NormSohl/daisy-freeze-pedal/pcb/carrier/drc-report.txt

** Drc report for /home/claude/daisy-freeze-pedal/pcb/carrier/carrier.kicad_pcb **
** Created on 2026-10-27 16:27:48 **

** Found 0 DRC violations **

** Found 0 unconnected pads **

** Found 0 Footprint errors **

** End of Report **
