NormSohl/daisy-freeze-pedal/enclosure/renders/back.png

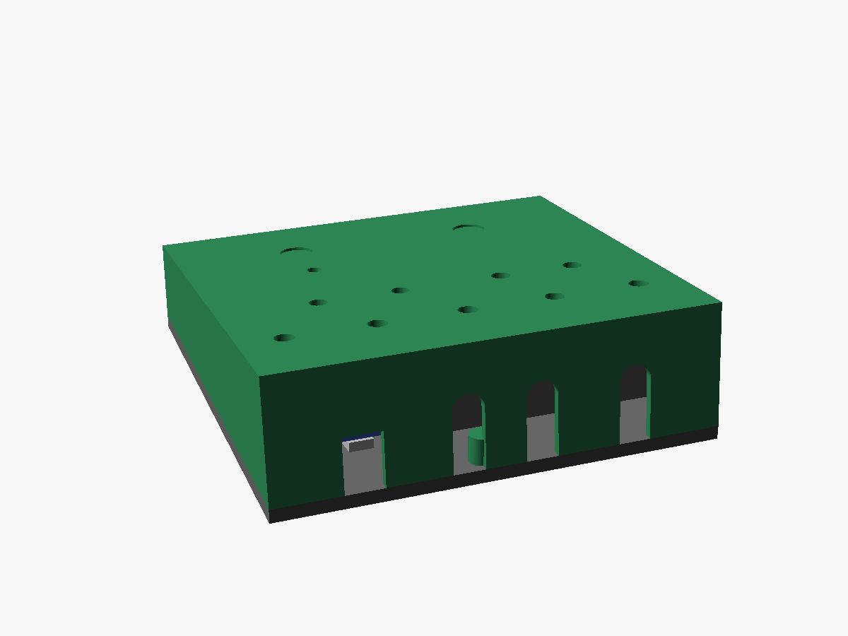
enclosure/renders/back.png
