NormSohl/daisy-freeze-pedal/enclosure/renders/shell-top.png

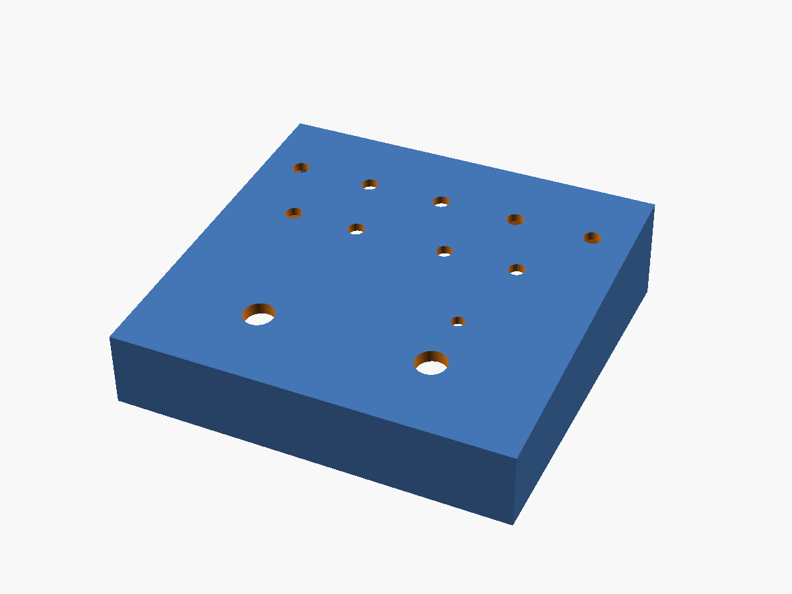
enclosure/renders/shell-top.png
