NormSohl/daisy-freeze-pedal/enclosure/renders/underside.png

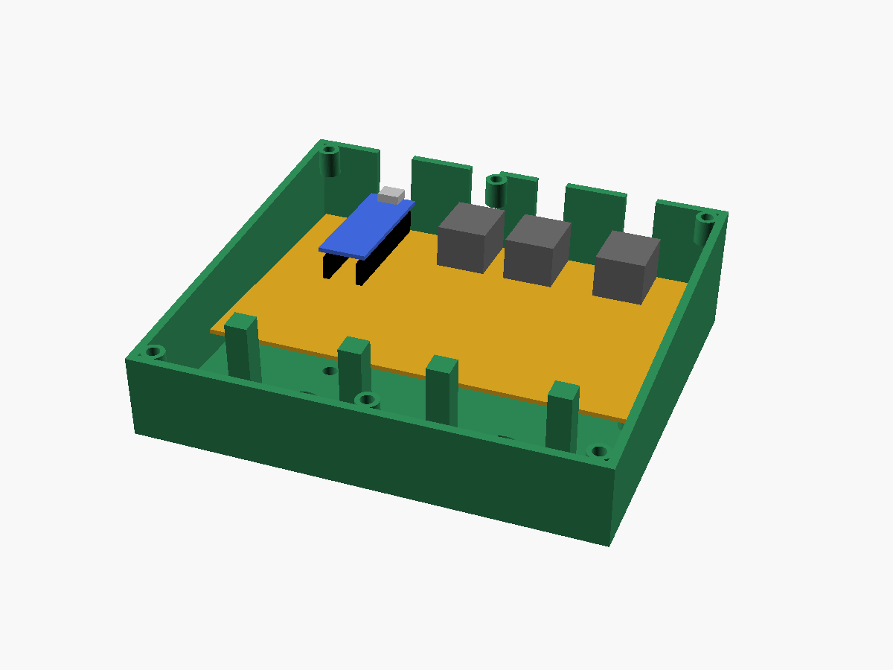
enclosure/renders/underside.png
