NormSohl/daisy-freeze-pedal/pcb/carrier/fab/bom.csv

Qty | References | Value | Part
2 | C1 C2 | 10u | 10 uF ≥25 V X7R radial MLCC, 5.08 mm leads (e.g. TDK FG20X7R1H106KRT06, 50 V, on Digi-Key)
1 | D1 | Red/Green | 5 mm bi-colour LED, common cathode (red/green), on a 4 mm spacer
1 | J1 | Freeze footswitch | No connector: solder 24-26 AWG leads into the J pads (either way round). Footswitch: soft-touch momentary SPST, panel mounted (Tayda)
1 | J2 | Clear footswitch | No connector: solder 24-26 AWG leads into the J pads (either way round). Footswitch: soft-touch momentary SPST, panel mounted (Tayda)
1 | J3 | In (mono; grounded when empty) | Neutrik NMJ6HCD2
1 | J4 | Out L / Mono | Neutrik NMJ6HCD2
1 | J5 | Out R (ring switch = plug detect) | Neutrik NMJ6HCD2
2 | R1 R2 | 470 | 470R 1/4 W (choose per LED)
2 | R3 R4 | 100k | 100k 1/4 W metal film
1 | RV1 | B10K Dry | Alpha RV09AF-40-20K-B10K (20 mm knurled shaft)
1 | RV2 | B10K Loop | Alpha RV09AF-40-20K-B10K (20 mm knurled shaft)
1 | RV3 | B10K −8 | Alpha RV09AF-40-20K-B10K (20 mm knurled shaft)
1 | RV4 | B10K +5 | Alpha RV09AF-40-20K-B10K (20 mm knurled shaft)
1 | RV5 | B10K +8 | Alpha RV09AF-40-20K-B10K (20 mm knurled shaft)
1 | RV6 | B10K Fade | Alpha RV09AF-40-20K-B10K (20 mm knurled shaft)
1 | RV7 | B10K Texture | Alpha RV09AF-40-20K-B10K (20 mm knurled shaft)
1 | SW1 | Single / Multi | E-Switch 100SP1T1B1M2RE (gold contacts; any 100SP1…M2 fits)
1 | SW2 | +5 up / down | E-Switch 100SP1T1B1M2RE (gold contacts; any 100SP1…M2 fits)
1 | U1 | Daisy Seed3 | Electrosmith Daisy Seed3 (on 2x 1x20 female headers)
