NormSohl/daisy-freeze-pedal/pcb/carrier/fab/mouser-bom.csv

Mfr Part Number | Manufacturer | Quantity | Customer Part Number | Description
RV09AF-40-20K-B10K | Alpha (Taiwan) | 8 | RV1-RV7 + spare | Pot 10K lin, 9 mm vertical, 20 mm knurled plastic shaft
100SP1T1B1M2RE | E-Switch | 2 | SW1 SW2 | Toggle SPDT on-on, PCB mount, 1/4-40 bushing, gold contacts
NMJ6HCD2 | Neutrik | 3 | J3 J4 J5 | 1/4 in TRS jack, horizontal PCB, switched
FG20X7R1H106KRT06 | TDK | 2 | C1 C2 | 10 uF 50 V X7R radial MLCC, 5 mm leads
PPTC201LFBN-RC | Sullins | 2 | U1 socket | 1x20 female header 2.54 mm, 8.5 mm tall, for Daisy Seed3
MFR-25FBF52-470R | Yageo | 5 | R1 R2 | 470 ohm 1/4 W metal film
MFR-25FBF52-100K | Yageo | 5 | R3 R4 | 100k 1/4 W metal film
WP59EGW | Kingbright | 2 | D1 | 5 mm red/green bi-colour LED, 3-lead common cathode
