NormSohl/daisy-freeze-pedal/enclosure/stl/plate.stl

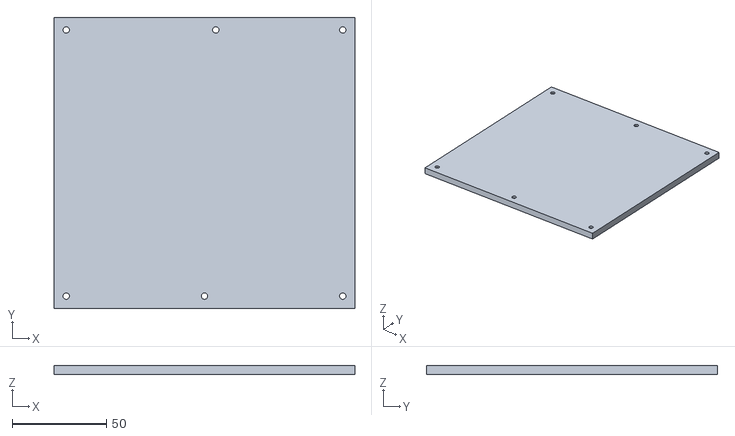
[picture p10: CAD file, 2026-10-28]
enclosure/stl/plate.stl
160.0 x 154.5 x 5.00
