NormSohl/daisy-freeze-pedal/enclosure/stl/shell.stl

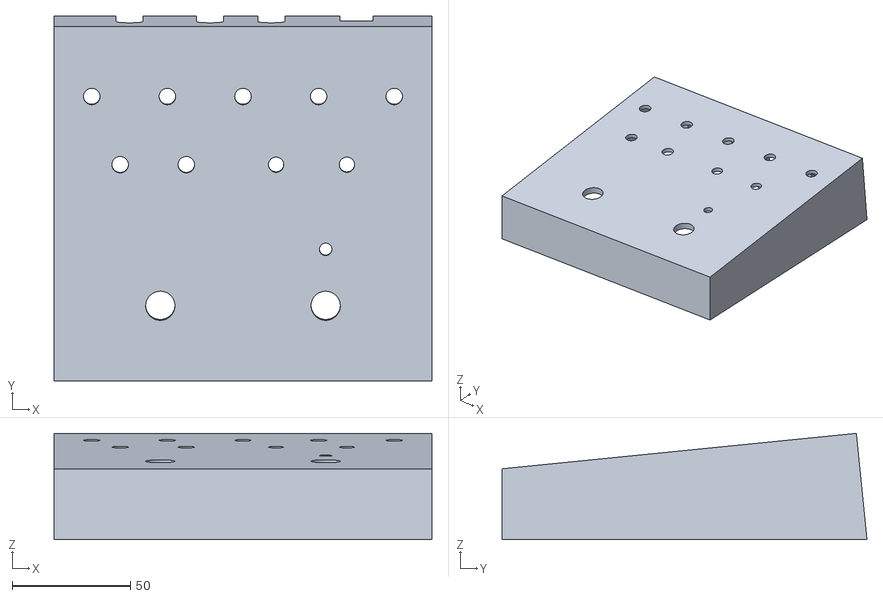
[picture p11: CAD file, 2026-10-28]
enclosure/stl/shell.stl
160.0 x 154.5 x 45.0
