NormSohl/daisy-freeze-pedal/pcb/carrier/carrier-schematic.pdf

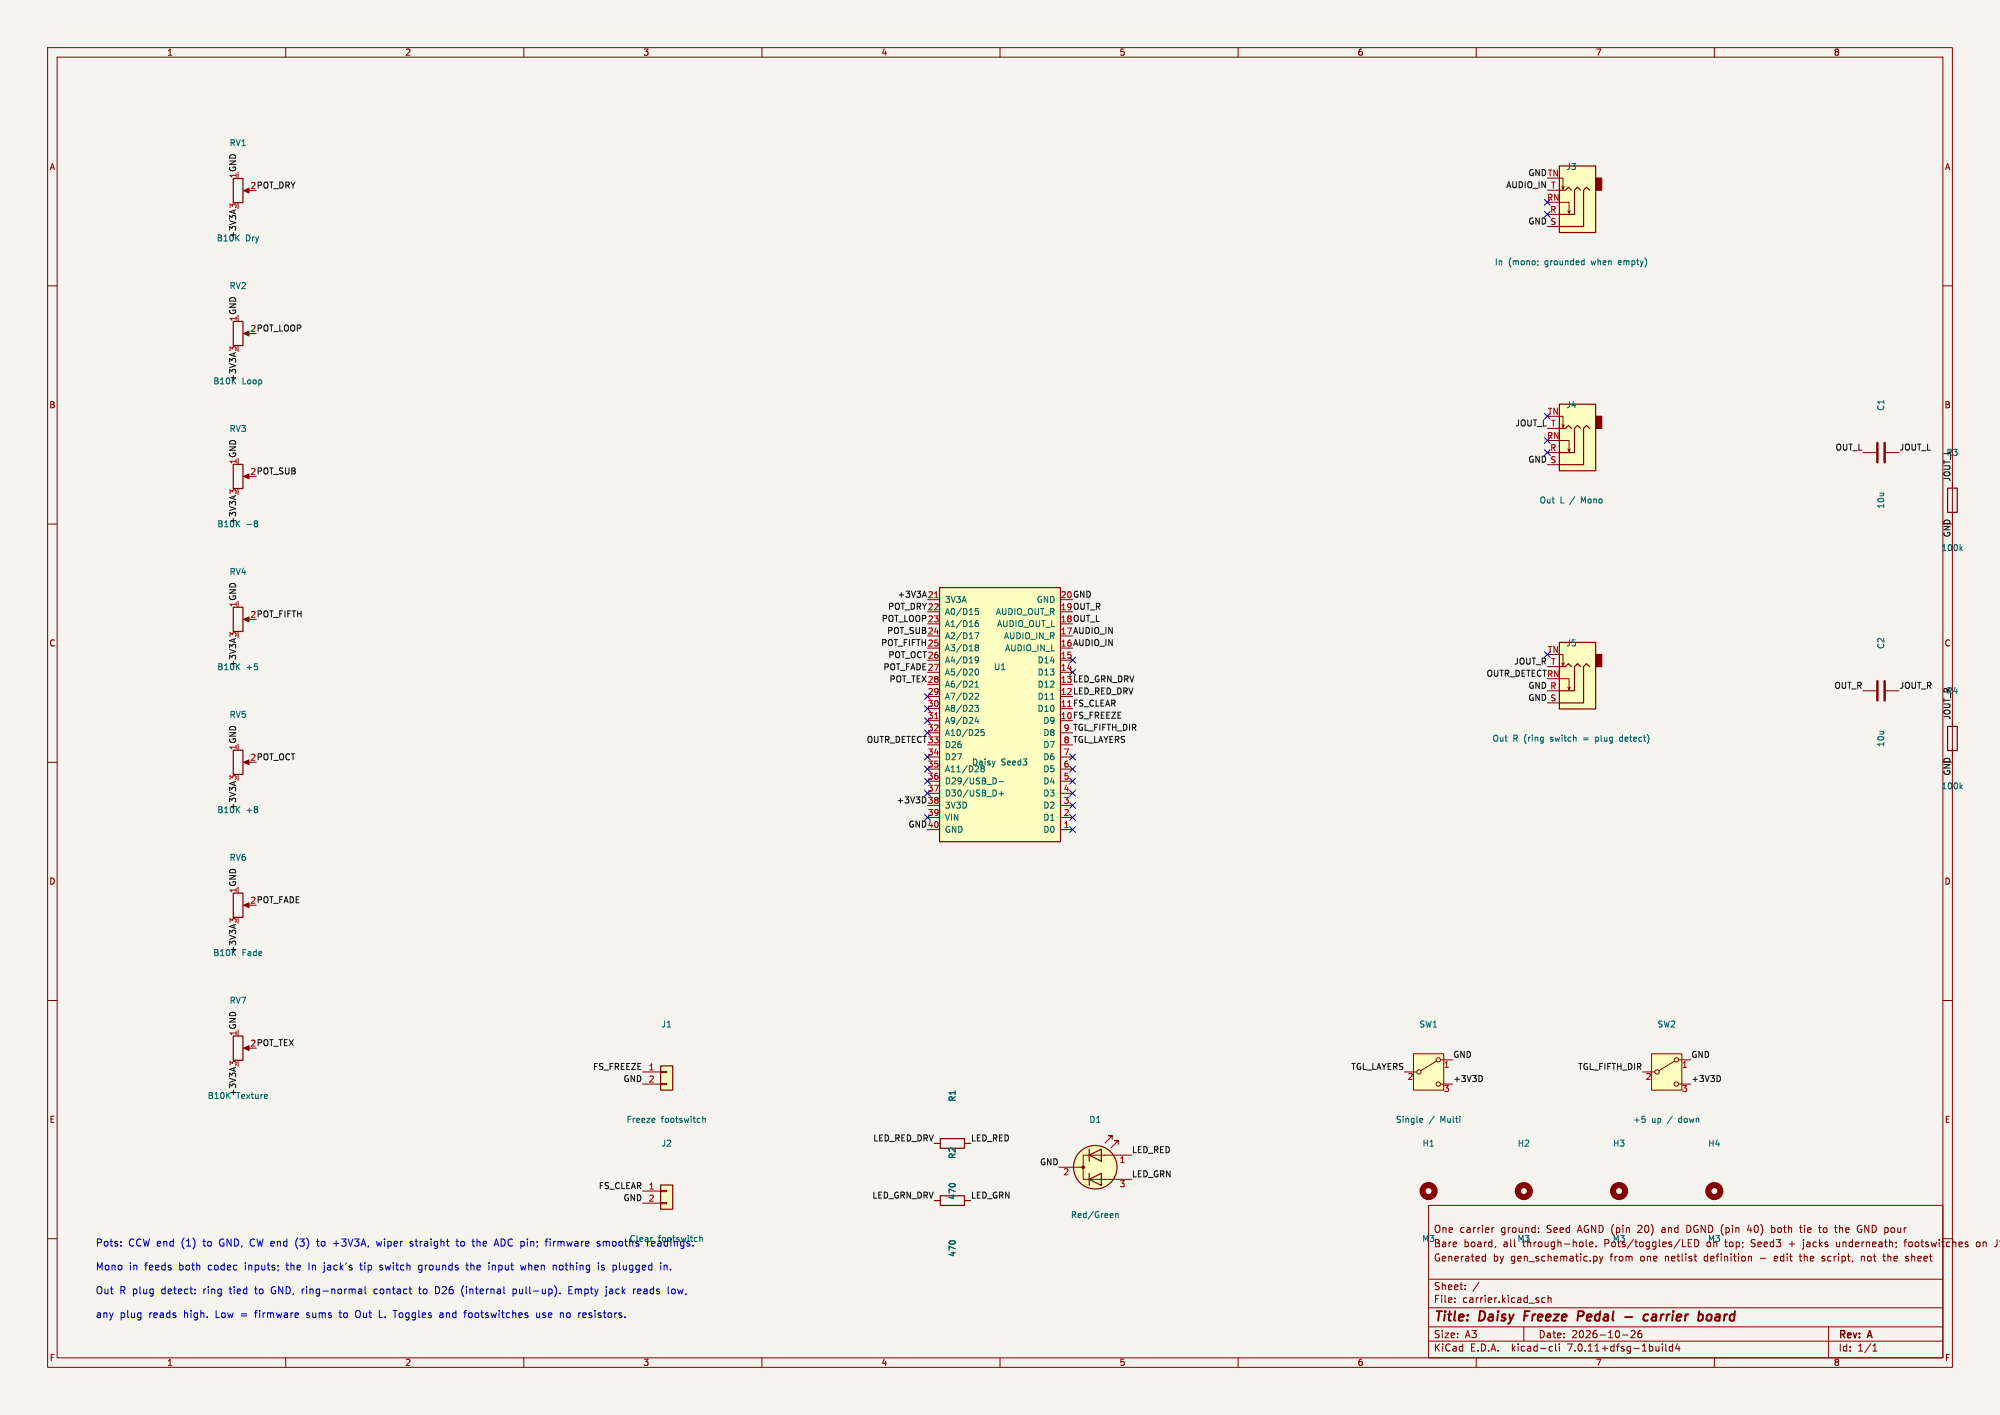
[picture p12: page 1]

Id: 1/1 Title: Daisy Freeze Pedal - carrier board
