NormSohl/daisy-freeze-pedal/pcb/carrier/carrier.kicad_pcb

## KiCad design pcb/carrier/carrier.kicad_pcb (2026-10-27)

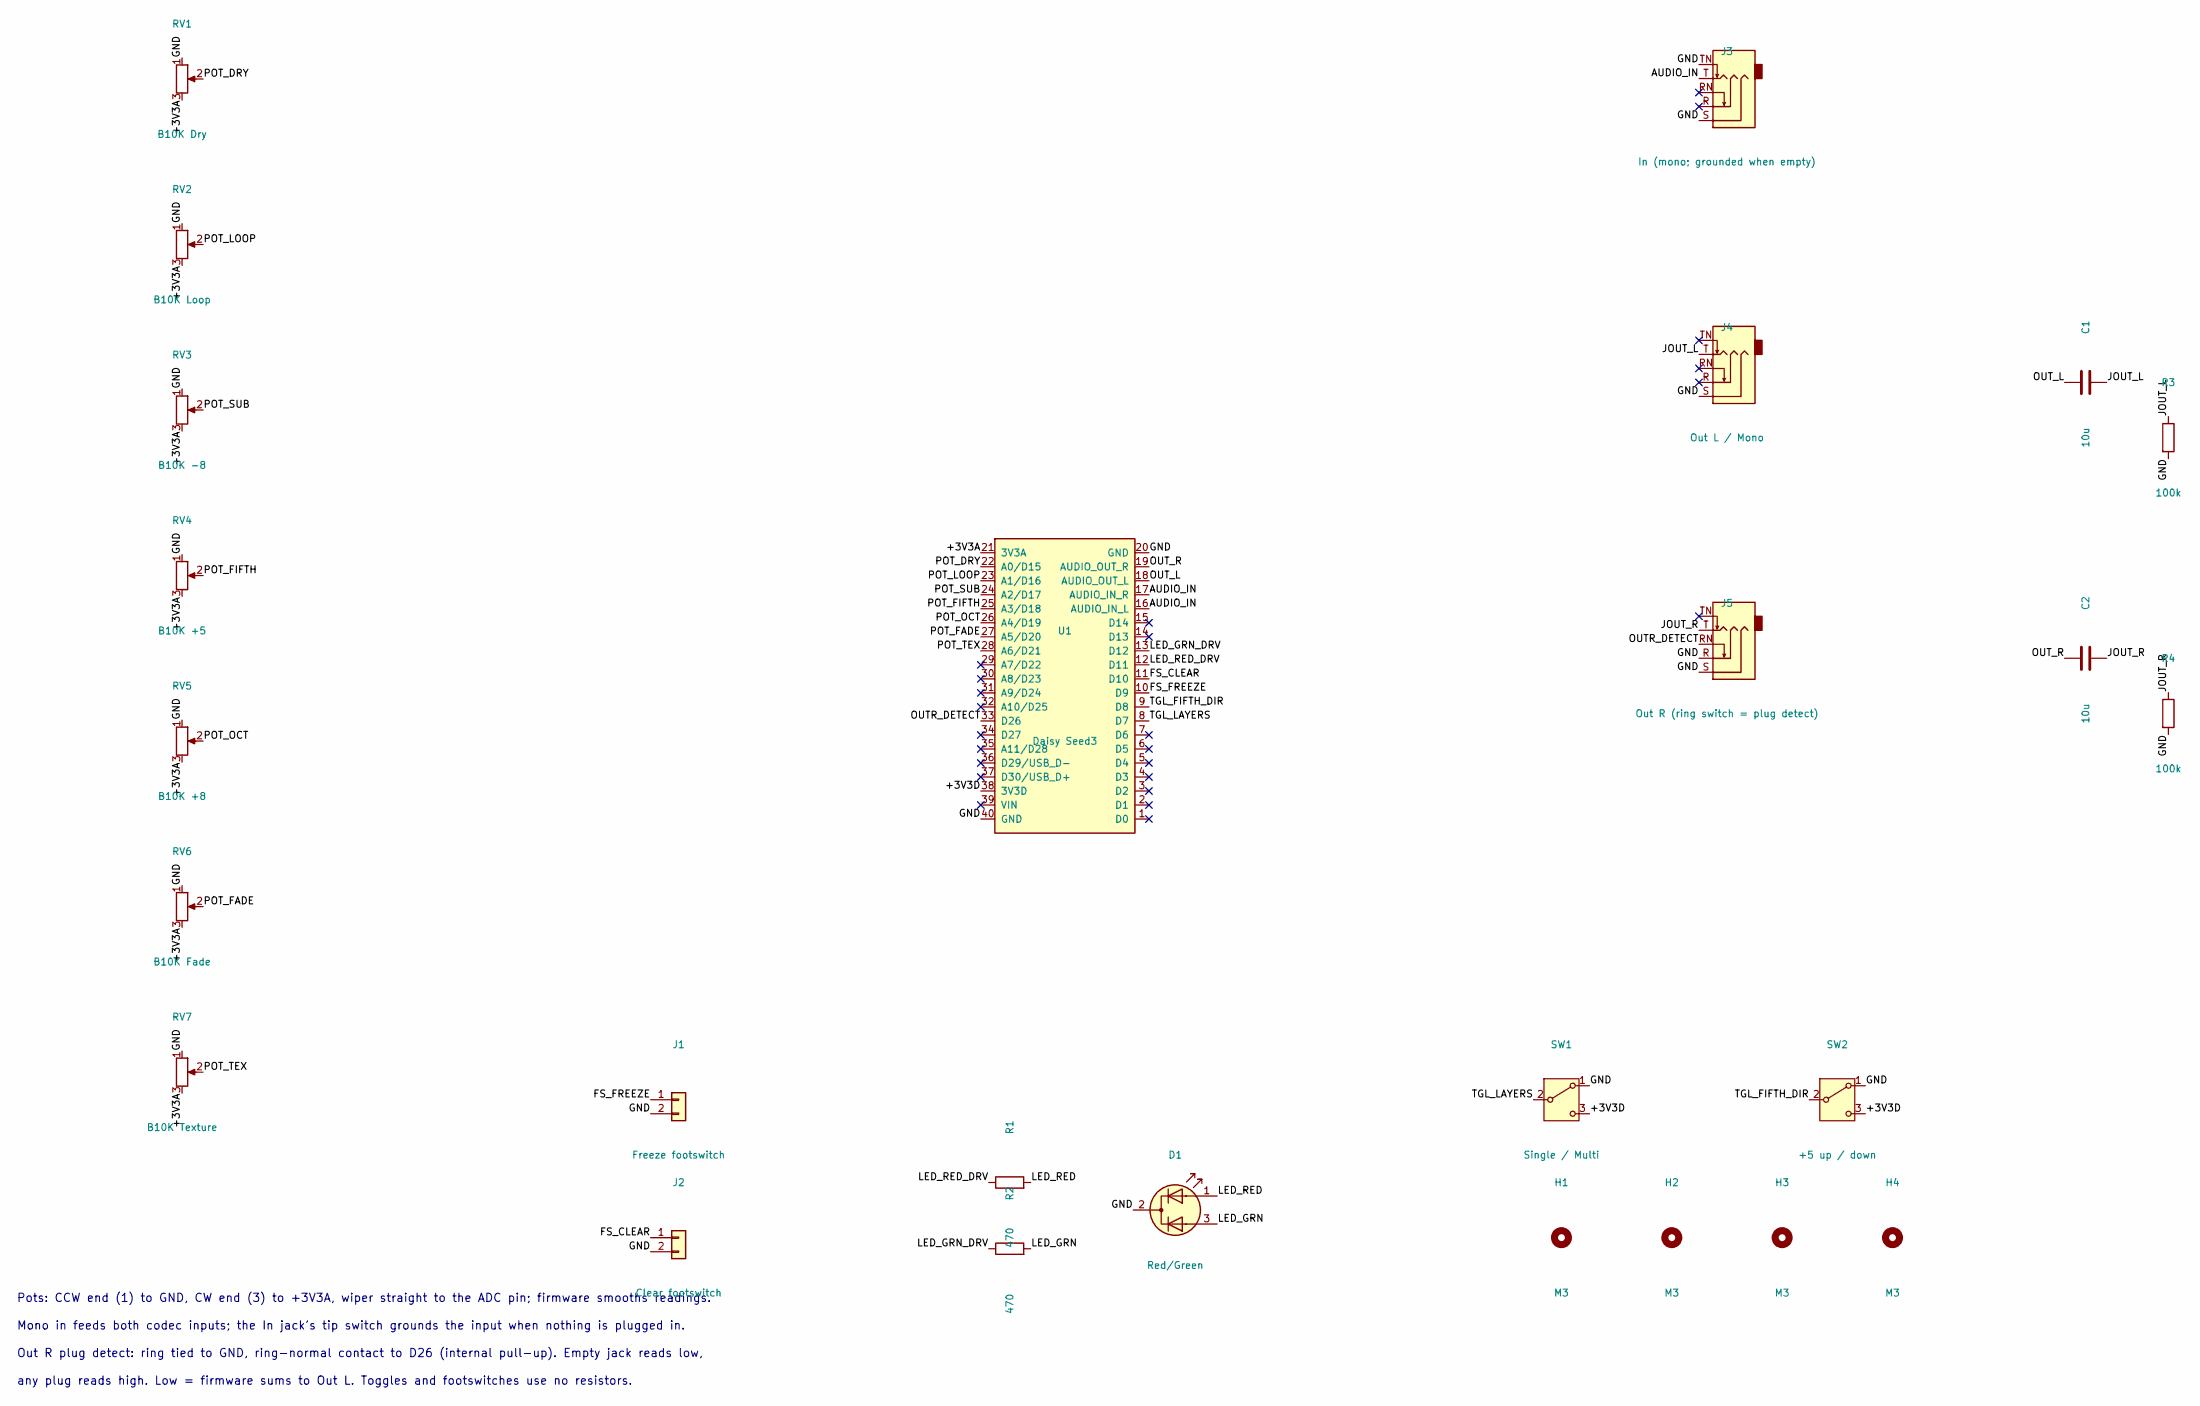
[picture p13: schematic carrier.kicad_sch, Daisy Freeze Pedal - carrier board]

Parts:
C1, C2: 10u; C_Disc_D5.0mm_W2.5mm_P5.00mm; MPN 10 uF 25 V X7R radial MLCC, 5.08 mm lea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
D1: Red/Green; LED_D5.0mm-3; MPN 5 mm bi-colour LED, common cathode (red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
H1, H2, H3, H4: M3; MountingHole_3.2mm_M3
J1: Freeze footswitch; JST_PH_B2B-PH-K_1x02_P2.00mm_Vertical; MPN JST B2B-PH-K; footswitch: soft-touch mo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
J2: Clear footswitch; JST_PH_B2B-PH-K_1x02_P2.00mm_Vertical; MPN JST B2B-PH-K; footswitch: soft-touch mo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
J3: In (mono; grounded when empty); Jack_6.35mm_Neutrik_NMJ6HCD2_Horizontal_FabOnlySilk; MPN Neutrik NMJ6HCD2
J4: Out L / Mono; Jack_6.35mm_Neutrik_NMJ6HCD2_Horizontal_FabOnlySilk; MPN Neutrik NMJ6HCD2
J5: Out R (ring switch = plug detect); Jack_6.35mm_Neutrik_NMJ6HCD2_Horizontal_FabOnlySilk; MPN Neutrik NMJ6HCD2
R1, R2: 470; R_Axial_DIN0207_L6.3mm_D2.5mm_P7.62mm_Horizontal; MPN 470R 1/4 W (choose per LED)
R3, R4: 100k; R_Axial_DIN0207_L6.3mm_D2.5mm_P7.62mm_Horizontal; MPN 100k 1/4 W metal film
RV1: B10K Dry; Potentiometer_Alpha_RV09AF-40_Vertical; MPN Alpha RV09AF-40-25K-B10K (25 mm knurled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
RV2: B10K Loop; Potentiometer_Alpha_RV09AF-40_Vertical; MPN Alpha RV09AF-40-25K-B10K (25 mm knurled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
RV3: B10K −8; Potentiometer_Alpha_RV09AF-40_Vertical; MPN Alpha RV09AF-40-25K-B10K (25 mm knurled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
RV4: B10K +5; Potentiometer_Alpha_RV09AF-40_Vertical; MPN Alpha RV09AF-40-25K-B10K (25 mm knurled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
RV5: B10K +8; Potentiometer_Alpha_RV09AF-40_Vertical; MPN Alpha RV09AF-40-25K-B10K (25 mm knurled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
RV6: B10K Fade; Potentiometer_Alpha_RV09AF-40_Vertical; MPN Alpha RV09AF-40-25K-B10K (25 mm knurled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
RV7: B10K Texture; Potentiometer_Alpha_RV09AF-40_Vertical; MPN Alpha RV09AF-40-25K-B10K (25 mm knurled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
SW1: Single / Multi; SW_E-Switch_100SP_M2_PCB; MPN E-Switch 100SP1T1B1M2QE
SW2: +5 up / down; SW_E-Switch_100SP_M2_PCB; MPN E-Switch 100SP1T1B1M2QE
U1: Daisy Seed3; DaisySeed_Socket_2x20; MPN Electrosmith Daisy Seed3 (on 2x 1x20 fe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

Connections:
+3V3A: RV1.3, RV2.3, RV3.3, RV4.3, RV5.3, RV6.3, RV7.3, U1.21 (3V3A)
+3V3D: SW1.3 (C), SW2.3 (C), U1.38 (3V3D)
AUDIO_IN: J3.T, U1.16 (AUDIO_IN_L), U1.17 (AUDIO_IN_R)
FS_CLEAR: J2.1, U1.11 (D10)
FS_FREEZE: J1.1, U1.10 (D9)
GND: D1.2 (K), J1.2, J2.2, J3.S, J3.TN, J4.S, J5.R, J5.S, R3.2, R4.2, RV1.1, RV2.1, RV3.1, RV4.1, RV5.1, RV6.1, RV7.1, SW1.1 (A), SW2.1 (A), U1.20 (GND), U1.40 (GND)
JOUT_L: C1.2, J4.T, R3.1
JOUT_R: C2.2, J5.T, R4.1
LED_GRN: D1.3 (A2), R2.2
LED_GRN_DRV: R2.1, U1.13 (D12)
LED_RED: D1.1 (A1), R1.2
LED_RED_DRV: R1.1, U1.12 (D11)
OUTR_DETECT: J5.RN, U1.33 (D26)
OUT_L: C1.1, U1.18 (AUDIO_OUT_L)
OUT_R: C2.1, U1.19 (AUDIO_OUT_R)
POT_DRY: RV1.2, U1.22 (A0/D15)
POT_FADE: RV6.2, U1.27 (A5/D20)
POT_FIFTH: RV4.2, U1.25 (A3/D18)
POT_LOOP: RV2.2, U1.23 (A1/D16)
POT_OCT: RV5.2, U1.26 (A4/D19)
POT_SUB: RV3.2, U1.24 (A2/D17)
POT_TEX: RV7.2, U1.28 (A6/D21)
TGL_FIFTH_DIR: SW2.2 (B), U1.9 (D8)
TGL_LAYERS: SW1.2 (B), U1.8 (D7)

Notes on the sheet:
Pots: CCW end (1) to GND, CW end (3) to +3V3A, wiper straight to the ADC pin; firmware smooths readings.
Mono in feeds both codec inputs; the In jack's tip switch grounds the input when nothing is plugged in.
Out R plug detect: ring tied to GND, ring-normal contact to D26 (internal pull-up). Empty jack reads low,
any plug reads high. Low = firmware sums to Out L. Toggles and footswitches use no resistors.

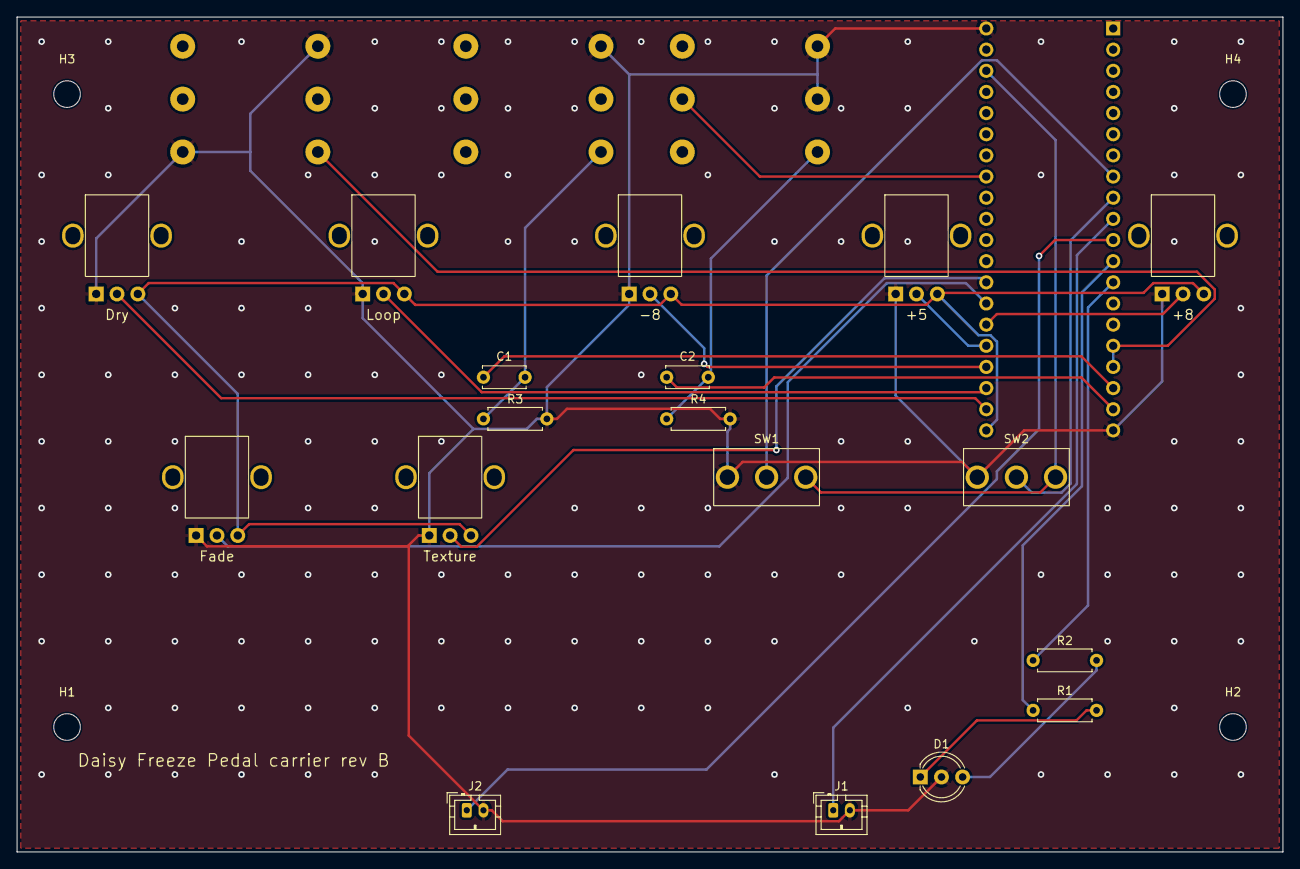
[picture p14: board carrier.kicad_pcb from above]

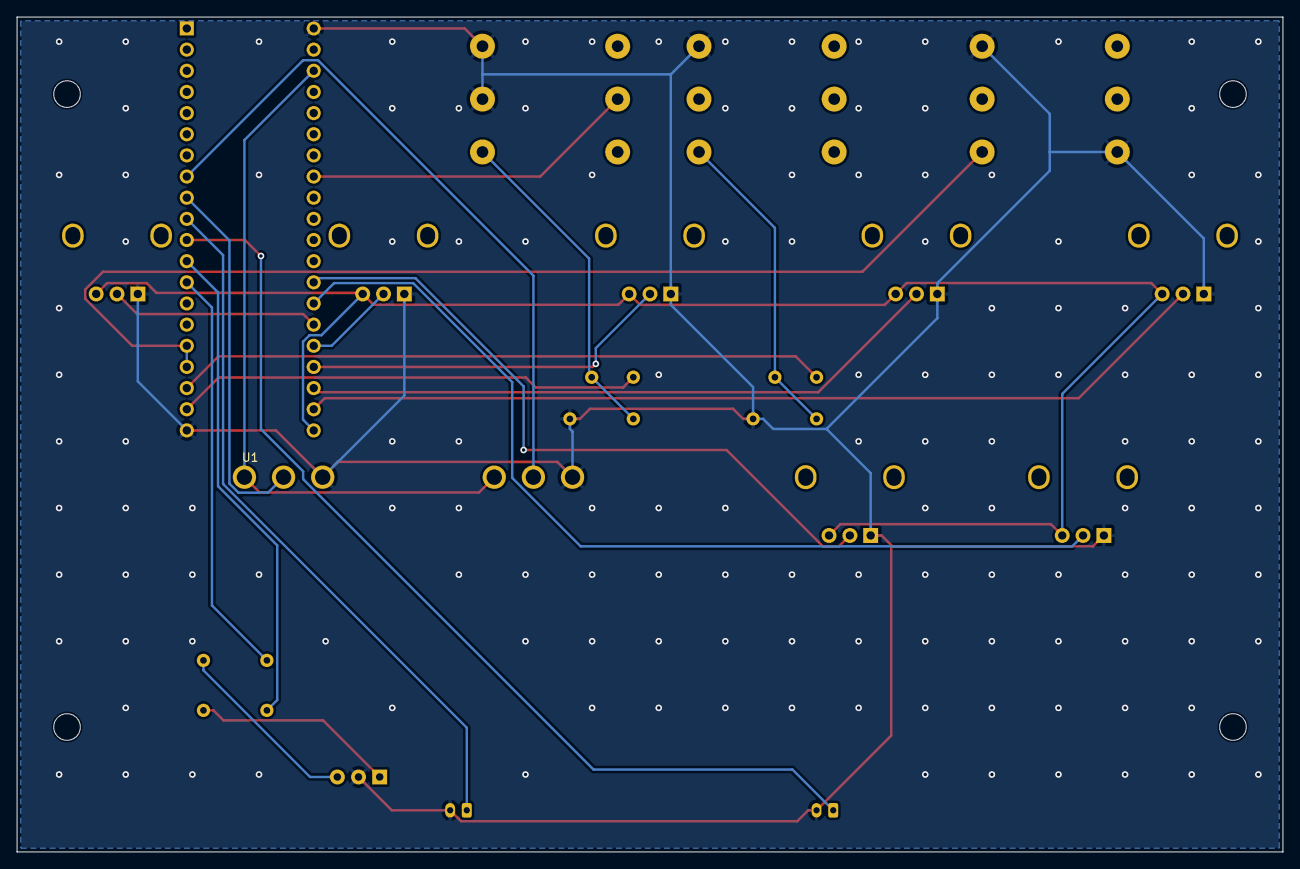
[picture p15: board carrier.kicad_pcb from below]

Board: 2 copper layers, 152.0 x 100.2 mm, 26 parts (4 on the bottom side), 24 nets.
