NormSohl/daisy-freeze-pedal/(commit log)

2026-10-27 Initial commit: bench prototype, enclosure model, README
    Browser bench of the freeze engine and pedal panel, parametric OpenSCAD
    wedge enclosure with first-pass STLs and renders, and a README covering
    the panel spec, I/O, hardware plan and enclosure design.
    Claude-Session: https://claude.ai/code/session_01JAavHVgiwWaG4iqEz4KA1Q
    [freeze_pedal_case.scad, plate.stl, shell.stl]
2026-10-27 Enclosure: 3/4" front edge, no plan taper, rows moved back
    Front edge is now 19 mm overall including the bottom plate, the body is a
    straight front-to-back wedge (17.7 deg panel), and the footswitch row moves
    up the slope to keep ~25.8 mm under the panel for the switch body.
    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
    [freeze_pedal_case.scad, plate.stl, shell.stl]
2026-10-27 Enclosure: 35 mm front, 50 mm back
    Lower, flatter wedge (5.7 deg). Rows return to their original positions
    with ~28 mm under the footswitches, and the back jacks drop to 15 mm so
    their bodies clear the carrier PCB.
    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
    [freeze_pedal_case.scad, plate.stl, shell.stl]
2026-10-27 Single carrier board: jacks and Seed on the underside
    All parts except the footswitches mount on one carrier PCB. Jacks and the
    Daisy Seed hang from its underside at the rear edge, with the Seed's
    micro-USB facing the back wall. The back wall is now perpendicular to the
    panel with bottom-open slots so the board slides up into place. Adds a
    carrier reference part and moves standoffs and the rear plate boss clear
    of the jacks.
    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
    [freeze_pedal_case.scad, plate.stl, shell.stl]
2026-10-27 Enclosure: flat panel face for face-down printing
    Removes the kick ridge, LED recess and pot collars so the shell prints
    face-down with no overhangs, and brings the carrier 2 mm closer to the
    panel so the panel holes bear the pot shafts. Adds a section render.
    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
    [freeze_pedal_case.scad, plate.stl, shell.stl]
2026-10-27 Pick toggles and pots; board gap set by toggle body
    E-Switch 100SP1T1B4M2QE PCB toggles (8.89 mm body) set the carrier 8.9 mm
    under the panel; Alpha RV09AF-40 pots with 25 mm plastic shafts, used bare
    without knobs. Adds a parts table to the README.
    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
    [freeze_pedal_case.scad, plate.stl, shell.stl]
2026-10-27 Pots: knurled shafts with translucent press-on caps
    Switches the pot choice to a 20 mm knurled 18T plastic shaft topped with
    small translucent knurled caps and an index line, AKS Mini style.
    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
2026-10-27 README: pin pot part number (Alpha RV09AF-40-20K-B10K)
    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
2026-10-27 Toggles and pots per datasheets
    The B4 toggle bushing is unthreaded, so switch to 100SP1T1B1M2QE (threaded
    1/4-40, 8.89 mm). Its PCB body is 6.6 mm, so the pots (7.0 mm) set the
    board gap at 7.5 mm and each toggle seats on a 0.9 mm pad under the panel,
    leaving 4.5 mm of thread for the nut. RV09 shaft length is measured from
    the PCB seating plane, so 20 mm shafts stand 9 mm above the panel.
    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
    [freeze_pedal_case.scad, plate.stl, shell.stl]
2026-10-27 Remove stale toggle comment
    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
    [freeze_pedal_case.scad]
2026-10-27 README: board assembly plan
    Hand-solder the through-hole parts, SMD small parts by hand or fab-placed,
    and solder the panel parts last with the board seated in the shell so
    everything lines up with its hole.
    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
2026-10-27 Carrier board: generated schematic and placed PCB
    KiCad 7 project generated from one netlist definition (gen_schematic.py)
    and from the enclosure geometry (gen_pcb.py reads it from the OpenSCAD
    model). Daisy Seed and four Neutrik NMJ6HCD2 jacks on the underside, pots,
    toggles, LED and footswitch connectors on top, fab-placeable 0603 SMD.
    Custom footprints for the Seed sockets, Alpha RV09AF-40 and E-Switch 100SP
    M2 from their datasheets. Netlist verified against the definition;
    placement checked for same-side courtyard overlaps and for through-hole
    pins under parts on the other side.
    Enclosure: jacks updated to NMJ6HCD2 datasheet geometry, top-row pots
    spaced 32 mm at s=121 and the Seed move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
    [carrier.kicad_pcb, carrier.kicad_sch, enclosure_params.scad, freeze_pedal_case.scad, plate.stl, shell.stl]
2026-10-27 Carrier board: routed, DRC clean, fab outputs
    route_pcb.py sets design rules, autoroutes with Freerouting (retrying
    until complete), imports the session file, and pours AGND on both
    layers; DRC reports 0 violations and 0 unconnected pads. make_fab.py
    writes Gerbers, drill files, a zip, and JLC-style BOM and placement
    files for the 21 top-side SMD parts.
    Pot mounting tabs are now plated (solderable). The jack footprint is a
    project copy with its outline on the fab layer, since the jack noses
    overhang the rear edge by design.
    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
    [bom-jlc.csv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]
2026-10-27 Carrier: single ground pour, verified parts
    AGND and DGND now tie to one carrier ground (R12 removed), poured on both
    layers and stitched with a via grid; re-routed, DRC 0 violations and 0
    unconnected. SMD parts carry manufacturer part numbers checked against
    their JLC part pages. README records the jack panel-thickness check
    (NMJ6HCD2 is rated under 4.7 mm) and the placement-rotation note.
    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
    [bom-jlc.csv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]
2026-10-27 Apply design review fixes (Seed3 target)
    Mechanical (from datasheets):
    - Jack axis is 7.53 mm off the PCB (NMJ6HCD2: 15.67 body, axis 8.14
    below its top), not 9.1; back-wall slots moved.
    - Toggle bushing base is 10.39 mm above the PCB (E-Switch catalog p.2
    body 8.89 + 1.5 mm M2 pin standoff), so the carrier now hangs 10.39 mm
    under the panel; pots move to 25 mm shafts (11.1 mm above the panel),
    toggles get 5.4 mm of thread for the nut.
    - Seed3 geometry: 18 mm wide, 2.5 mm header spacer, USB-C axis 14.2 mm
    below the carrier; USB slot widened to 14 x 9 mm.
    - LED sits on a 5 mm spacer to reach its panel hole.
    Electrical:
    - Out R plug detect now uses the ring-normal contact with the r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
    [bom-jlc.csv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]
2026-10-27 README: drop the test print; ream undersize holes instead
    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
2026-10-27 Rev B carrier: bare board, all through-hole, mono in / stereo out
    Drops fab assembly. The board is all through-hole with six small parts:
    two output coupling caps, two bleed resistors, two LED resistors. Pot
    RC filters, supply caps, input pads, the In R jack and the plug-detect
    resistors are gone (pots straight to the ADCs, Out R detect and switches
    on internal pull-ups). Mono input feeds both codec inputs; stereo out
    kept. Three jacks on the back wall. Re-routed, DRC 0 violations.
    make_fab.py now writes Gerbers plus a hand-solder bom.csv.
    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
    [bom-jlc.csv, bom.csv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]
2026-10-27 Enclosure: bore footswitch holes through the panel; document plate mounting
    The footswitch pad bore stopped short and left a plug in each footswitch
    hole. All panel holes now probe clear, and the bottom-plate screw axes
    probe clear through the plate into each boss's insert pocket. README
    describes the plate fixing (6x M3x8 SHCS into heat-set inserts) with an
    exploded render.
    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
    [freeze_pedal_case.scad, plate.stl, shell.stl]
2026-10-28 Enclosure: 2.5 mm top panel for stocked 20 mm pots
    The 25 mm RV09AF-40 shaft isn't stocked by US distributors, so the BOM
    now calls for the 20 mm part (Mouser, Jameco, Tayda). The toggles fix the
    board 10.39 mm under the panel, so the only way to keep shaft above the
    panel is a thinner panel: 3.5 -> 2.5 mm gives 7.1 mm of shaft. Toggle
    thread above panel rises to 6.4 mm, LED spacer shortens to 4 mm,
    footswitch clearance rises to about 29 mm. Gerbers are unchanged
    (the ordered boards still fit). STLs regenerated; all panel holes probe clear.
    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
    [bom.csv, carrier.kicad_sch, freeze_pedal_case.scad, plate.stl, shell.stl]
2026-10-28 BOM: Digi-Key-friendly toggle (with nuts) and capacitor, 4 mm LED spacer
    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
    [bom.csv, carrier.kicad_sch]
2026-10-28 Add Mouser BOM upload (xlsx + csv)
    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
    [mouser-bom.csv, mouser-bom.xlsx]
2026-10-28 BOM: gold-contact toggle 100SP1T1B1M2RE (same body and pins)
    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
    [bom.csv, carrier.kicad_sch, freeze_pedal_case.scad, mouser-bom.csv, mouser-bom.xlsx]
2026-10-28 Drop JST connectors: footswitch leads solder straight into J1/J2
    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
    [bom.csv, carrier.kicad_sch, mouser-bom.csv, mouser-bom.xlsx]
